Imprezwag/3d/README.md

# Soporte del bidón

Soporte imprimible en 3D para llenar botellas desde la bomba eléctrica de un bidón de 20 L sin tener que sostenerlas.

Página con todas las versiones: **https://imprezwag.github.io/3d/**

## Versiones

| Versión | Fecha | Descripción | Visor 3D | Archivos |
|---|---|---|---|---|
| **V2.0** (actual) | 17/10/2026 | Abraza el cuello del bidón y se apoya en su parte más ancha; no depende del mueble. Cuna que encastra con un clic | [Abrir](https://imprezwag.github.io/3d/v2.0/) | [v2.0/](v2.0/) |
| V1.1 | 17/10/2026 | Se cuelga de la tabla frontal del mueble; botella en copa y aro en C, boca pegada al pico | [Abrir](https://imprezwag.github.io/3d/v1.1/) | [v1.1/](v1.1/) |

## Cómo se organiza el repo

- Cada versión vive en su propia carpeta (`v1.1/`, `v2.0/`, ...) con su visor 3D (`index.html`), sus STL, su modelo paramétrico y su README.
- Cada versión publicada puede marcarse además como release en GitHub (Releases → Draft a new release, con la etiqueta `v1.1`), para guardar ese estado exacto.
- La página de inicio (`index.html` en la raíz) lista todas las versiones. Al sumar una versión nueva, se agrega su tarjeta ahí y su fila en esta tabla.
