Imprezwag/3d/v2.0/stl/collar.stl

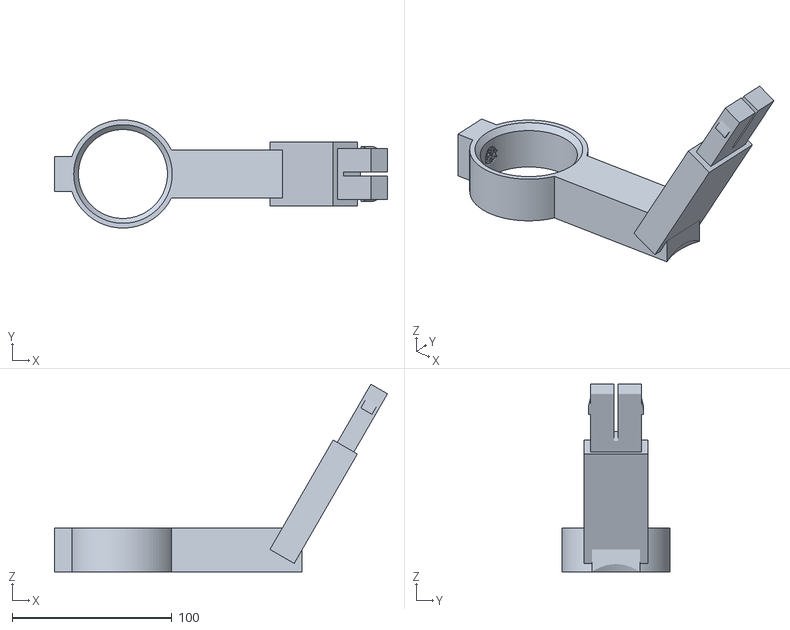
[picture p6: CAD file, 2026-10-17]
v2.0/stl/collar.stl
208.2 x 67.6 x 117.3
