Imprezwag/3d/v2.0/stl/tornillo_trasero.stl

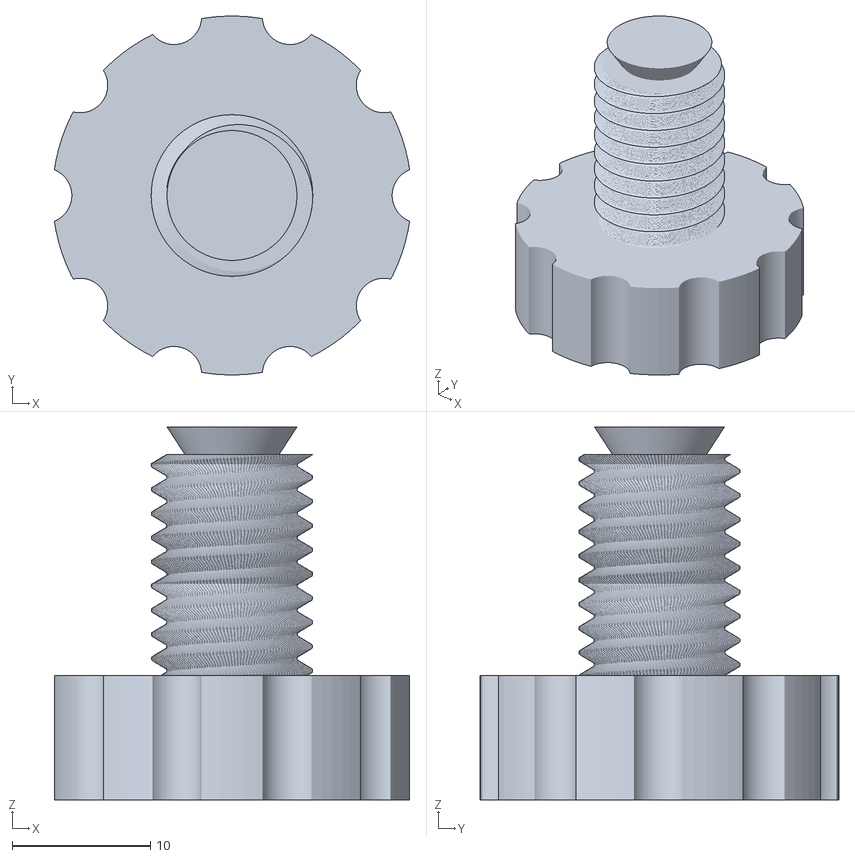
[picture p7: CAD file, 2026-10-17]
v2.0/stl/tornillo_trasero.stl
25.7 x 26.0 x 27.0
