Imprezwag/3d/v2.0/stl/cuna.stl

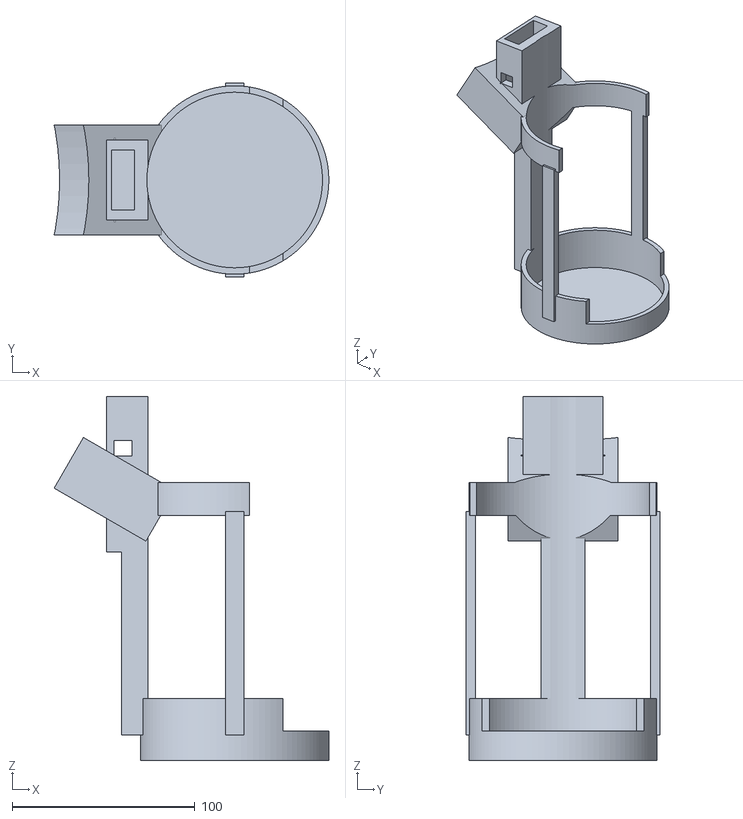
[picture p8: CAD file, 2026-10-17]
v2.0/stl/cuna.stl
150.2 x 106.0 x 199.0
