Imprezwag/3d/v2.0/stl/suplemento_B_40mm.stl

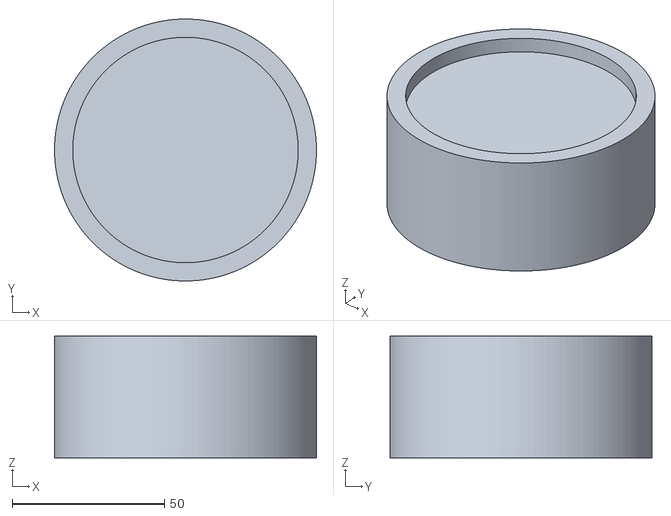
[picture p10: CAD file, 2026-10-17]
v2.0/stl/suplemento_B_40mm.stl
86.0 x 86.0 x 40.0
