Imprezwag/3d/v2.0/stl/reductor_aro_500ml.stl

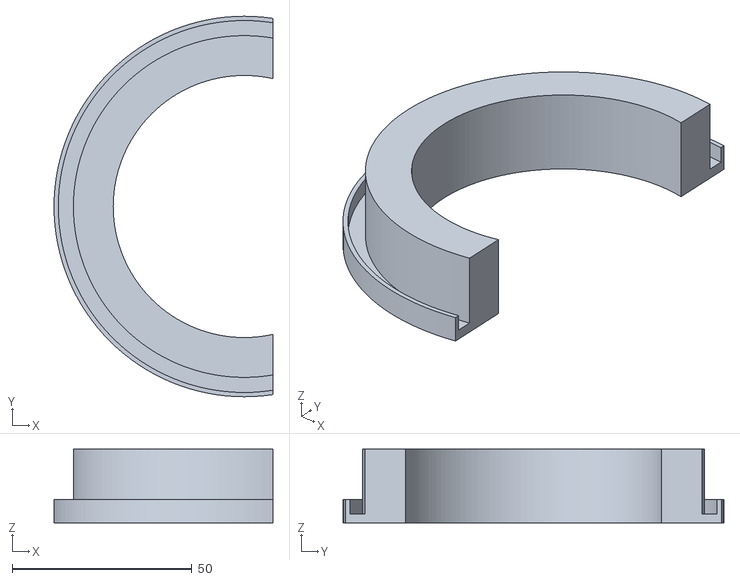
[picture p11: CAD file, 2026-10-17]
v2.0/stl/reductor_aro_500ml.stl
61.0 x 106.0 x 20.5
