Imprezwag/3d/v2.0/stl/suplemento_A_60mm.stl

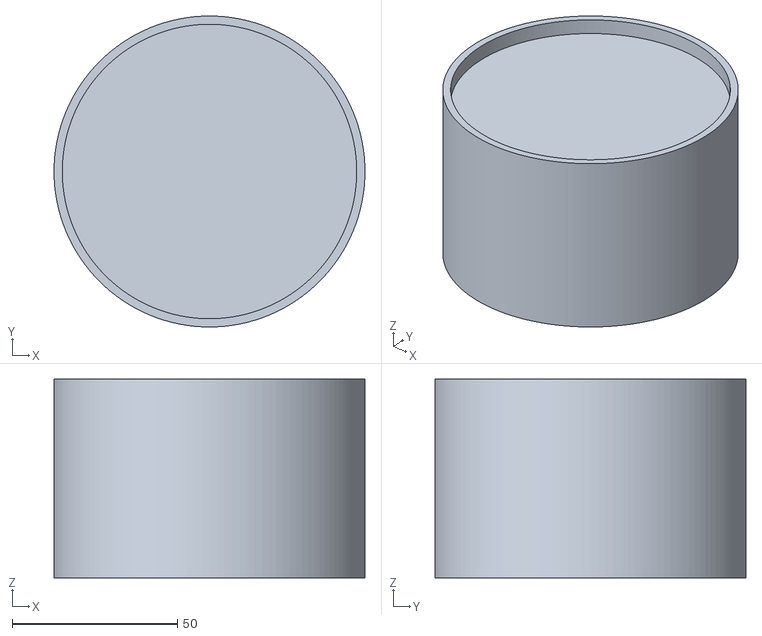
[picture p12: CAD file, 2026-10-17]
v2.0/stl/suplemento_A_60mm.stl
94.0 x 94.0 x 60.0
