Imprezwag/3d/v1.1/stl/soporte_principal.stl

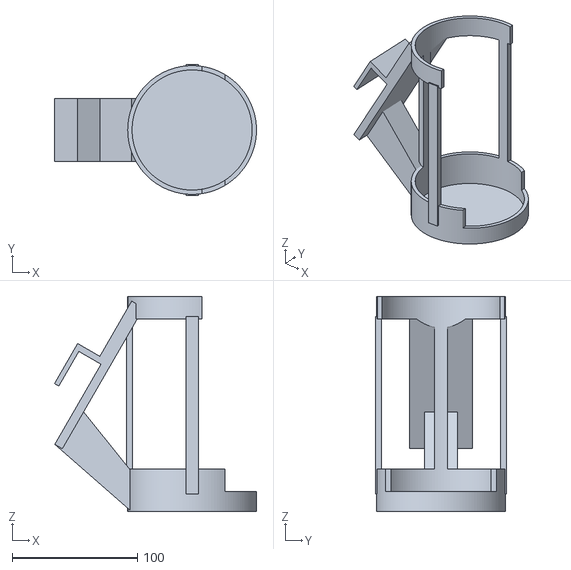
[picture p13: CAD file, 2026-10-17, an earlier design]
v1.1/stl/soporte_principal.stl
161.6 x 105.0 x 172.0
