Imprezwag/3d/(commit log)

2026-10-17 Soporte del bidón V.1: STL, modelo paramétrico y visor 3D
    Claude-Session: https://claude.ai/code/session_01N13pmVBPSuGUy9xHV9mxs2
    [reductor_aro_1L.stl, reductor_aro_500ml.stl, soporte_principal.stl, suplemento_A_60mm.stl, suplemento_B_40mm.stl]
2026-10-17 Organizar por versiones: V1.1 en su carpeta y página de inicio con todas las versiones
    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
    [reductor_aro_1L.stl, reductor_aro_500ml.stl, soporte_principal.stl, suplemento_A_60mm.stl, suplemento_B_40mm.stl]
2026-10-17 V2.0: soporte que abraza el cuello del bidón y se apoya en su parte más ancha
    Carpeta v2.0 con visor 3D, STL, modelo paramétrico, imágenes y README.
    La página de inicio y el README suman la V2.0 como versión actual.
    Claude-Session: https://claude.ai/code/session_01FB9N8oEi58FBZmXkLpRjZD
    [collar.stl, cuna.stl, reductor_aro_1L.stl, reductor_aro_500ml.stl, suplemento_A_60mm.stl, suplemento_B_40mm.stl, tornillo_trasero.stl]
